waynechen16/handset_iface/pcb_bottom.png

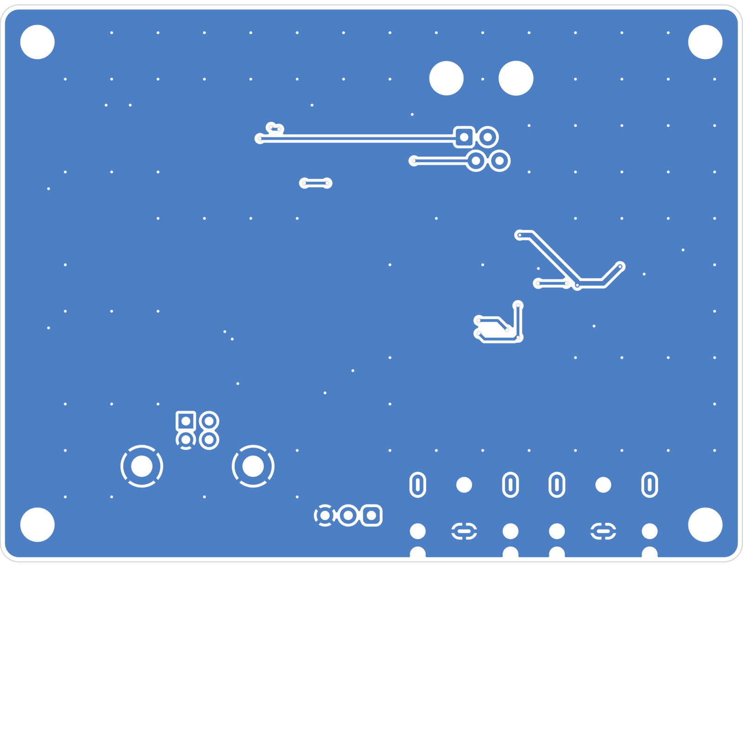
pcb_bottom.png
