waynechen16/handset_iface/pcb_top.png

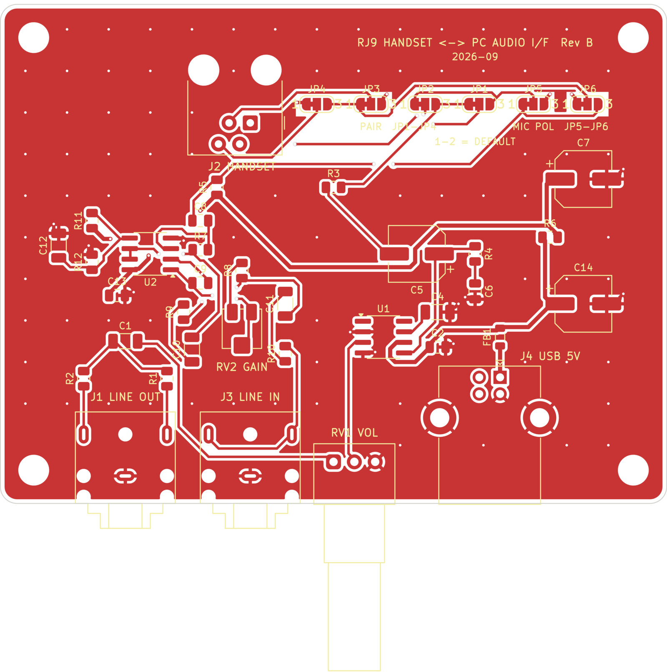
pcb_top.png
