waynechen16/handset_iface/handset_iface_sch.pdf

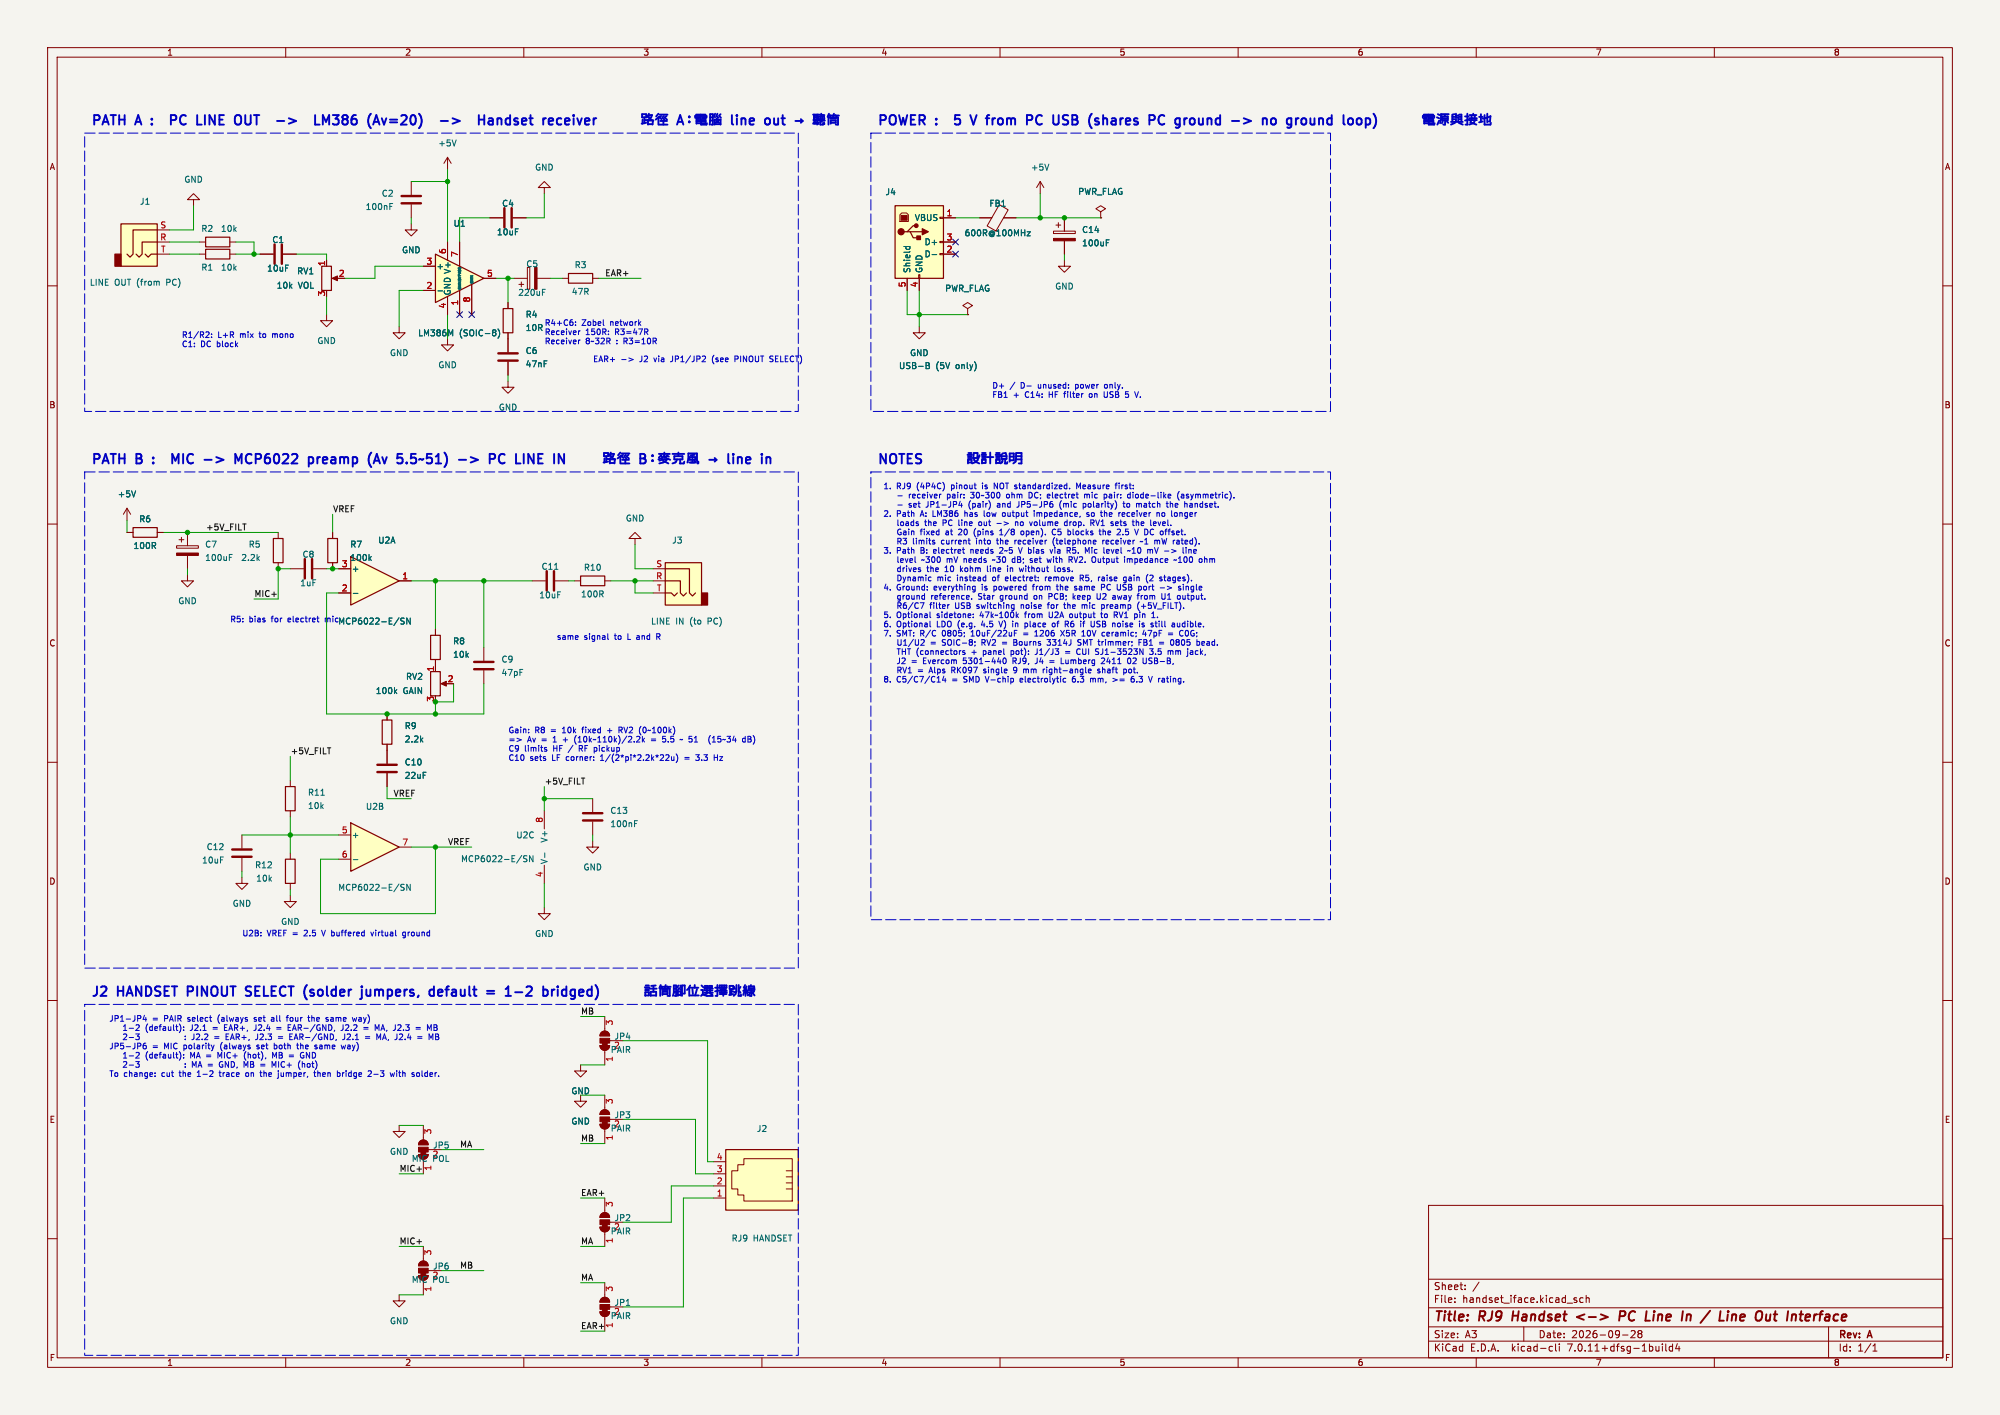
[picture p3: page 1]

LINE IN (to PC) R3
