waynechen16/handset_iface/(commit log)

2026-09-28 Rev A: initial schematic and 2-layer PCB layout
    - Path A: PC line out -> LM386 -> handset receiver, RV1 volume
    - Path B: electret mic bias + MCP6022 preamp (RV2 gain) -> PC line in
    - 5 V from USB-B with ferrite / RC filtering, 2.5 V buffered VREF
    - 80 x 60 mm 2-layer board: J1/J3/RV1/J4 on bottom edge, J2 RJ9 on top edge
    - Fab outputs: Gerber + drill zip, SMT position file, BOM
    Claude-Session: https://claude.ai/code/session_01BD8MrKfAbaxkYcuZ7XEioP
    [handset_iface.kicad_pcb, handset_iface.kicad_sch, handset_iface_BOM.csv, handset_iface_pos_top.csv]
2026-09-28 Rev B: add J2 handset pinout-select solder jumpers JP1-JP6
    Analog handsets differ in which RJ9 pair carries the receiver and in
    electret mic polarity. J2 now connects through six 3-pad solder jumpers
    (default 1-2 bridged = Rev A pinout):
    - JP1-JP4 (PAIR): swap receiver pair 1/4 <-> 2/3
    - JP5-JP6 (MIC POL): choose which mic-pair pin is MIC+
    Layout: jumper row to the right of J2 on the top edge, re-routed,
    DRC 0 errors / 0 unconnected. Fab outputs, BOM and README updated.
    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
    [handset_iface.kicad_pcb, handset_iface.kicad_sch]
